arpruss/BLEBike/schematic.png

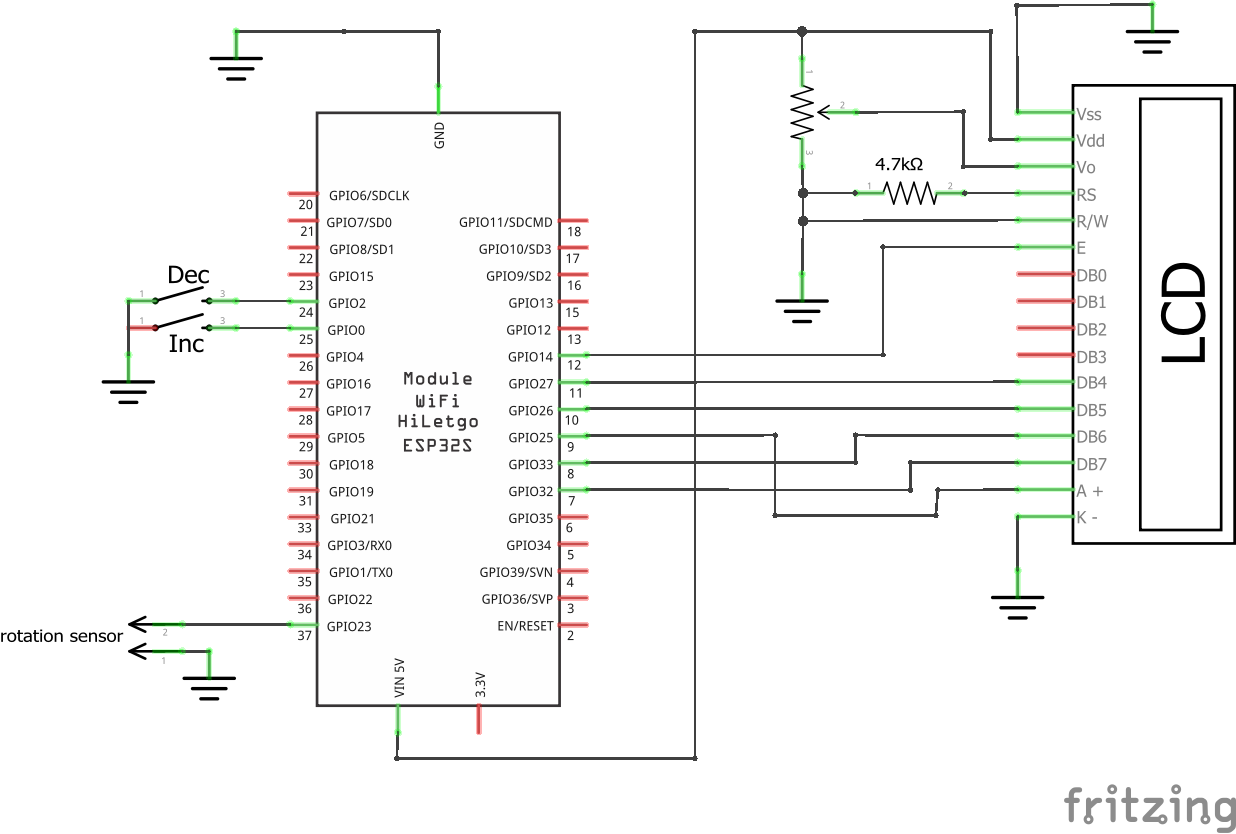
schematic.png
