arpruss/BLEBike/(threads)

Thread 1 (2023-03-22):

Cadence RPM seems to be half

MortenVinding, 2023-03-22:
Hi arpruss,

Your project is just what I need.

I have converted it to a platformio project in my fork here: https://github.com/MortenVinding/BLEBike.git
But it seems like the RPM counter is counting only half the revolutions.
Is this configurable on the display I haven't connected since I don't have a HD44780 display at hand?

/Morten

arpruss, 2023-03-23:
Do you know what the RPM sensor output is like on your bike? Is it normally high, with a low spike (how long?)? Or the other way around?

MortenVinding, 2023-03-23:
Also I only measured with a multimeter.
It’s normally high (4.29 volts if memory serves), and the low pulse seemed to be responsible long.

I will scoope that also later.
But it is precisely half of the build-in RPM display.
Changing the 60000 / in the code to 30000 / made it bang-on with the bikes computer.

arpruss, 2023-03-23:
Why don't you add a bit of code to the interrupt handler to toggle an LED reach time it detects a rotation, and then see what happens when you rotate the pedals slowly: do you miss every second one? You can also hook up a multimeter at the same time and make sure there was a signal that it missed.

It wouldn't surprise if there was some bug in my code. The ESP has trouble with triggering interrupts on a specific edge, and so I have to trigger on both edges and kludgily drop one.

Could be the same with the heart rate.

MortenVinding, 2023-03-23:
> Why don't you add a bit of code to the interrupt handler to toggle an LED each time it detects a rotation, and then see what happens when you rotate the pedals slowly: do you miss every second one? You can also hook up a multimeter at the same time and make sure there was a signal that it missed.

Great idea. I will do that. And also hook up my scope.

> It wouldn't surprise if there was some bug in my code. The ESP has trouble with triggering interrupts on a specific edge, and so I have to trigger on both edges and kludgily drop one.

Ahh that could also very well explain the half RPM number. So maybe for some weird reason, my ESP32 is only triggering on one of the edges.

> Could be the same with the heart rate.

Might yes. But there must also be something else going on, because it's much more off. Around 2-3 BPM when the bike registers around 70 BPM.

arpruss, 2023-03-24:
On my bike, there are two different heart lines. There are the lines to the sensors, and you are unlikely to be able to catch anything on them without some circuitry to amplify the faint signals, and there are digitally processed signals -- nice square waves -- that should be easier to work with. But I never actually tried that heart code, because I ended up getting a chest band, and so now I integrate that data over bluetooth.

MortenVinding, 2023-03-24:
Ohh and don't worry about the voltages, I forgot to zero out the DSO138 (yes it's a cheap scope 😆)
They do go 0-3.3 volt (rotation) and 0-4.2 volt (heart).

arpruss, 2023-03-24:
I wouldn't expect serial print to work inside an interrupt handler. Interrupt handlers need to move fast.

Did you configure the LED in your setup() (i.e., `pinMode(LED,OUTPUT)`)?  Then you need a bit of code like:
` static uint8_t ledState = 0; digitalWrite(LED, ledState); ledState = !ledState; `
in the ISR.

I suggest starting with putting that code right at the beginning of rotationISR();. You should only see a brief blink of the LED, because the width of the signal is narrow.

arpruss, 2023-03-24:
Try this. At the beginning of the ISR: digitalWrite(LED,digitalRead(rotationDetectPin)). This should exactly duplicate the rotation detect pin on the LED if both edges are being captured. If you can't tell from the LED what is going on, put the scope on the LED pin (or use a different output pin). Ideally you'd use a two-channel scope, one for the LED and the other for the rotation detect, and see if both channels are the same, but you can make-do with just one channel.

MortenVinding, 2023-03-24:
Thanks.

That seems to work reliably. The LED is on in a little more than 3/4 of the revolution and of in little less than 1/4.
So I guess it triggers the interrupt on both edges after all?

But if I change
`uint32_t rpm;
  uint32_t _power = _lastPower;
  if (!rev || _lastRotationDuration == 0)
    rpm = 0;
  else if (_lastRotationDuration < t - prevRotationMarker) {
    rpm = 60000 / (t - prevRotationMarker);
    _power = calculatePower(t - prevRotationMarker);
  }
  else
    rpm = 60000 / _lastRotationDuration;`

to 120000 instead of 60000, the RPM number is exactly the same as the bike computers.

arpruss, 2023-03-25:
I would rather figure out what is wrong than just change the timing to make it work, since even if that works for you, it won't work for others (e.g., it won't work for me).

I have two more test sfor you. Comment out these lines:
```
if (t < lastBounce + rotationMarkerDebounceTime) {
    lastBounce = t;
    return;
  }
```
And see if now the timing is right. If it is, then maybe play a bit with the rotationMarkerDebounceTime and making it smaller and see if that solves your problem.

If this doesn't solve the problem, then move the LED code to right before the `uint32_t t = millis();` line.

MortenVinding, 2023-03-25:
Absolutely agree.
It was only to explain that the RPM number is exactly half of the real.

I tried removing the `(t < lastBounce + rotationMarkerDebounceTime)` part but it did not change anything.
Haven't tried to put the LED code before `uint32_t t = millis();` but I did have it in the very top of the rotationISR part before.
Btw: I use the `ledPin` you have already configured in the code (that is GPIO 2 and the internal LED on my board).

I noticed that `lastBounce` is used both in `rotationISR` and `heartISR`, don't know if that's a problem.
I triede to rename it in the `rotationISR` handler, but that also didn't change anything.

Thank you so much for your help.

arpruss, 2023-03-25:
The use of the same bounce timer is definitely an issue I should look into.

arpruss, 2023-03-30:
lastBounce is static, so it's local to the two functions. No problem there.

Add an LED toggler at the end of rotationISR().
`static uint8_t ledState = 0; digitalWrite(LED, ledState); ledState = !ledState;`
Then you should have the LED toggling once per full rotation. Do you?

MortenVinding, 2023-03-31:
> Then you should have the LED toggling once per full rotation. Do you?

I already did that per your instructions before, but I tried to move it to the bottom of the rotationISR().
And yes it toggles once per revolution. Only once.

I think there is something strange going on with the ISR, because the heartbeat is way off, but if I swap the heart and rotation input, the rotation (now triggered by the heart sensor), is also exactly half of my heart rate (as displayed by the bike computer), and the heart rate (now triggerede by the rotation sensor) is showing the same strange behaviour as when the heart sensor was connected to it.

arpruss, 2023-03-31:
Toggling once per rotation is correct behavior. So the problem is somewhere else.

MortenVinding, 2023-03-31:
> Toggling once per rotation is correct behavior. So the problem is somewhere else.

but I thought there was a problem with the ESP32 interrupts triggering on both the rising and falling edge?

don’t you divide by 2 in the code? (I can’t figure it out. I’m terrible programmer 🙄)

arpruss, 2023-03-31:
Yes, the interrupt handler does trigger on rise and fall. But the following code makes sure that the fall is ignored:
```
if (cleanRotationMarkerState != defaultRotationMarkerValue)
    return;
  // trigger on end of marker
```
Try disabling the heart code completely (comment out `#define HEART_PIN`) and see if the rotation works better.

Another thing to try. After the `rpm = 60000 / _lastRotationDuration;` line, print to serial both the rpm and _lastRotationDuration. Then using a stopwatch, rotate the pedals slowly, so that a rotation takes about three seconds. Compare the three seconds the _lastRotationDuration (which is in milliseconds).

MortenVinding, 2023-04-01:
> Yes, the interrupt handler does trigger on rise and fall. But the following code makes sure that the fall is ignored:

Ahh of course!

> Try disabling the heart code completely (comment out `#define HEART_PIN`) and see if the rotation works better.

Tried. No change :(

> Another thing to try. After the `rpm = 60000 / _lastRotationDuration;` line, print to serial both the rpm and _lastRotationDuration. Then using a stopwatch, rotate the pedals slowly, so that a rotation takes about three seconds. Compare the three seconds the _lastRotationDuration (which is in milliseconds).

I added:
```
    Serial.print("RPM: ");
    Serial.println(rpm);
    Serial.print("_lastRotationDuration: ");
    Serial.println(_lastRotationDuration);
```
Pictures of output from it, from the bike computer and screenshot from Zwift.
Maybe I should try a different app?

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

arpruss, 2023-04-01:
So it looks like it IS correctly counting the rpm, but there is some problem in the transmission to Zwift.

The code sends data over multiple bluetooth services: cadence, power, heart and fitness. Based on your data, I think Zwift is picking up the fitness service data. Turn off the fitness service in the code (remove the FITNESS define at the top). See what happens.

MortenVinding, 2023-04-01:
> Turn off the fitness service in the code (remove the FITNESS define at the top). See what happens.

Wheee that was IT!!
Now the RPM is spot on!

That is so cool 💪

Unfortunately the heart rate is still too low. I will try the same with the serial debug messages on that now.

arpruss, 2023-04-02:
There is still a bug in the fitness service, or at least a compatibility problem with Zwift.

MortenVinding, 2023-04-02:
Ohh okay sorry…

arpruss, 2023-04-07:
I should have read the specs more carefully. Cadence in FTMS is measured in half-units. Your 120,000 fix was basically right. I corrected this, and also improved the rounding.

Closed 2023-04-07.

Thread 2 (2023-03-22):

Heart rate sensor is counting very low

MortenVinding, 2023-03-22:
I have build for heart sensor on pin 19.
It's connected to the existing heart sensor circuit in my exercise bike to pin 19, but it is counting very low. Not even 1/10 og the actual heart rate, maybe 1/80 - 1/100.
I can't really figure out the calculation, so hope you can help med figure out what is wrong.

/Morten

arpruss, 2023-03-23:
I haven't tested this functionality, so it wouldn't surprise me if there were a bug in it. How does your bike's sensor signal look? Is it a nice square wave?

MortenVinding, 2023-03-23:
Wow quick response 😊

That’s a very fair question.
The input is from a dedicated heart sensor circuit on the bike, but I have only measured it with a multimeter.
I have a simple DSO120 scope, I can hook up later today.

This is the heart circuit:
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

MortenVinding, 2023-04-01:
added:
```
    Serial.print("heartRate: ");
    Serial.println(heartRate);
    Serial.print("lastHeartRateTime: ");
    Serial.println(lastHeartRateTime);
```
right here:
```
#ifdef HEART_PIN
  static uint32_t lastHeartRateUpdate = 0;

  if (millis() >= lastHeartRateUpdate + 1000 && lastHeartBeatDuration > 0 && millis() <= prevHeartBeat + 4000) {
    uint16_t heartRate = (10000 + lastHeartBeatDuration/2) / lastHeartBeatDuration;
    lastHeartRate = heartRate;
    lastHeartRateTime = prevHeartBeat;
    Serial.print("heartRate: ");
    Serial.println(heartRate);
    Serial.print("lastHeartRateTime: ");
    Serial.println(lastHeartRateTime);
```

But the heartRate is exactly the same as reported in Zwift.

Do you have any suggestions to where I might add some more debug output?

arpruss, 2023-04-02:
Try changing the 10000 to 60000.

MortenVinding, 2023-04-02:
> Try changing the 10000 to 60000.

Guess you looked in my fork, because there I have already raised it from 1000 to 10000 😉
I now have tried to change it to 60000. I looks to be close, but now maybe a bit to high.
But the heart measurement seems to anyway be a bit unreliable, also for the build in computer. So maybe it's just that.

I would say it's good enough now.
Next step for me is implementing resistance control. That might be a bit more involved, but I hope I can steal some code from this: https://github.com/doudar/SmartSpin2k

All though my requirements are different, since my bike already have electrically controlled resistance using a small motor and a feedback potentiometer.

Once again, thank you so much for your help. Really appreciated.

In time I might make som pull requests, if you would like the OTA update feature etc.
