arpruss/BLEBike/schematic.pdf

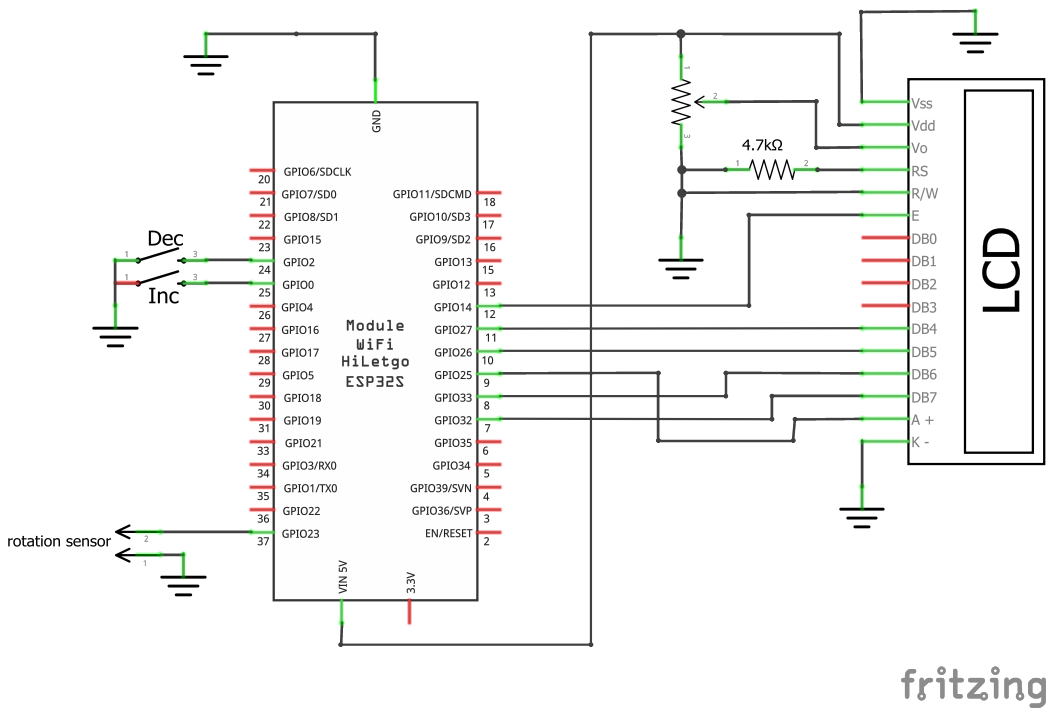
[picture p2: page 1]
