arpruss/BLEBike/BLEBike.ino

/*
 * MIT License
*/

#include <NimBLEDevice.h>
#include <NimBLEUtils.h>
#include <NimBLEServer.h>
#include <ArduinoNvs.h> // https://github.com/rpolitex/ArduinoNvs
#include "debounce.h"

#define SUPPORT_WIFI

#ifdef SUPPORT_WIFI
#include <WiFi.h>
#include "/Users/arpruss/Documents/Arduino/private.h"
IPAddress localIP(MY_IP);
IPAddress gateway(MY_GATEWAY);
IPAddress subnet(MY_SUBNET);
#define MY_PORT 8765
WiFiServer tcpServer(MY_PORT);
#endif

#define POWER
#define CADENCE
#define FITNESS
//#define HEART_BEACON 
//#define HEART_PIN 19 // untested
#define HEART_CLIENT

//#define WHEEL // Adds WHEEL to cadence; not supported in power as that would need a control point
#define LIBRARY_HD44780
#define PULLUP_ON_ROTATION_DETECT // handy for debugging

#if defined(HEART_BEACON) || defined(HEART_PIN) || defined(HEART_CLIENT)
# define HEART
#endif

#define HEART_MIBAND_UUID16 0xFEE0 

#define DEVICE_NAME "BLEBike"
const uint32_t rotationDetectPin = 23;

#ifdef LIBRARY_HD44780
# include <hd44780.h>
# include <hd44780ioClass/hd44780_pinIO.h> // Arduino pin i/o class header
#else
# include <LiquidCrystal.h>
#endif

#define COLS 20
#define ROWS 4

const int rs = 12, en = 14, d4 = 27, d5 = 26, d6 = 33, d7 = 32;
#define BACKLIGHT 25
// 1-16 on LCD board
// Left / Right on ESP32 with USB port at bottom
// Positions of pins may differ on your board.
// GND = Left from bottom 6, Right from top 7, Right from top 1
// 1 = GND -- Left from bottom 6
// 2 = VCC -- 5V = Left from bottom 1 (perhaps via diode?)
// 3 -- contrast pot wiper: right goes to +5V and left goes to GND
// 4 = RS -- GPIO12 = Left from bottom 7 -- 4.7k -- GND
// 5 = RW -- GND
// 6 = EN -- GPIO14 = Left from bottom 8
// 11 = D4 -- GPIO27 = Left from bottom 9
// 12 = D5 -- GPIO26 = Left from bottom 10
// 13 = D6 -- GPIO33 = Left from bottom 12
// 14 = D7 -- GPIO32 = Left from bottom 13
// 15 = GPIO25 -- Left from bottom 11
// 16 = GND
// Bike GND -- GND = Right from top 1
// Bike Detect -- GPIO23 = Right from top 2
// GND -- switch -- GPIO0 = Right from bottom 6
// GND -- switch -- GPIO4 = Right from bottom 7

#ifdef LIBRARY_HD44780
hd44780_pinIO
#else
LiquidCrystal 
#endif
lcd(rs, en, d4, d5, d6, d7);

byte bluetoothIcon[8] = {
  B00110, //..XX.
  B10101, //X.X.X
  B01110, //.XXX.
  B00100, //..X..
  B01110, //.XXX.
  B10101, //X.X.X
  B00110, //..XX.
  B00000, //.....
};

byte heartIcon[8] = {
   B00000,
   B01010,
   B10101,
   B10001,
   B10001,
   B01010,
   B00100,
   B00000
};
   

const uint32_t ledPin = 2;
const uint32_t incPin = 0;
const uint32_t decPin = 4; 
Debounce incButton(incPin, LOW);
Debounce decButton(decPin, LOW);
bool ignoreIncRelease = false;
bool ignoreDecRelease = false;
bool needToClear = true;
unsigned curX = 0;
unsigned curY = 0;
const uint8_t defaultRotationMarkerValue = 1; // this is what is there most of the time
uint8_t cleanRotationMarkerState = defaultRotationMarkerValue; // most likely
const uint8_t defaultHeartSensorValue = 1;
uint8_t cleanHeartSensorState = defaultHeartSensorValue;
const uint32_t rotationMarkerDebounceTime = 20;
const uint32_t heartSensorDebounceTime = 2;
const uint32_t minimumUpdateTime = 250;
const uint32_t idleTime = 4000; 
const uint32_t longPressTime = 2000;
bool cadenceServiceEnabled = true;
bool powerServiceEnabled = true;
bool heartServiceEnabled = true;
bool fitnessServiceEnabled = true;
bool heartReadEnabled = true;
bool showPeleton = true;
bool updateBluetooth = false;
bool wiFiMode = false;

uint32_t prevRotationMarker = 0;
uint32_t rotationMarkers = 0;
uint32_t lastRotationDuration = 0;
uint32_t lastPower = 0;
uint32_t pedalStartTime = 0;
uint64_t millijoules = 0;
uint32_t pedalledTime = 0;
#ifdef HEART_PIN
uint32_t heartBeats = 0;
uint32_t lastHeartBeatDuration = 0;
uint32_t prevHeartBeat = 0;
#endif
#ifdef HEART_BEACON
bool needToReportHeartRate = false;
uint64_t heartAddress=0;
uint8_t heartAddressType=1;
int bestHeartRSSI=-1000000;
uint64_t bestHeartAddress=0;
NimBLEScan* heartScan;
#define HEART_SENSOR_ON_WRIST
#endif
#ifdef HEART_CLIENT
bool needToReportHeartRate = false;
uint64_t heartAddress=0;
uint8_t heartAddressType=1;
int bestHeartRSSI=-1000000;
uint64_t bestHeartAddress=0;
NimBLEScan* heartScan;
NimBLEClient* heartClient = NULL;
NimBLEAdvertisedDevice* heartDevice;
bool needToConnectHeart = false;
uint32_t heartConnectAttemptTime;
unsigned heartConnectRetry=0;
const unsigned heartConnectRetries=5;
const uint32_t heartConnectRetryTime = 10000;
#endif

#ifdef HEART
uint32_t lastHeartRate = 0;
uint32_t lastHeartRateTime = 0;
#endif
bool detectedRotation = false;

uint32_t lastUpdateTime = 0;

#ifdef WHEEL
const uint32_t gearRatio1 = 1; // gearRatio1:gearRatio2 = wheel rotations:crank rotations
const uint32_t gearRatio2 = 2; 
#endif

#define GROSS_EFFICIENCYx1000 195 // 195 recumbent, 206 upright, at max power output: https://doi.org/10.3389/fspor.2021.667564
#define MJ_TO_KCALx1000 239
#define NUM_RESISTANCES 8
#define RADIUSX1000 149 // radius of crank in meters * 1000 (= radius of crank in mm)

#define FV(x) (uint32_t)(2 * PI * RADIUSX1000 * (x) + 0.5)

// compile-time calculations are down with floating point, but run-time calculation are all integer
//#define MECHANICAL_FRICTION_BIKE
#ifdef MECHANICAL_FRICTION_BIKE
// resistance model: force = - mechanicalFriction
const uint32_t mechanicalPartsX1000[NUM_RESISTANCES] = 
   { FV(7.5),FV(15.5),FV(20.5),FV(35.5),FV(50.5),FV(70.4),FV(70.9),FV(90.3) };
   // replace the numbers by your mechanical friction values in Newtons
#define WATTS(rpm,i) ( mechanicalPartsX1000[(i)] / 1000. * (rpm)/60. )
#else
// resistance model: force = - resistanceCoeffRots * rotationsPerTime - mechanicalFriction
// The following are the k values from https://www.instructables.com/Measure-Exercise-Bike-Powercalorie-Usage/
// multiplied by a factor of 10.
const uint32_t resistanceCoeffRotsX10[NUM_RESISTANCES] = {285,544,802,1052,1393,1671,1873,1969}; 
const uint32_t _2_pi_r_100000 = (uint32_t) (2 * PI * RADIUSX1000 * 100 + 0.5);
const uint32_t mechanicalPartX1000 = FV( 7.84 );   // mechanical friction measured at 7.84 Newtons
#define WATTS(rpm,i) ( (2 * PI * (RADIUSX1000/1000.) * (rpm)/60. * ( resistanceCoeffRotsX10[(i)]/10.*(rpm)/60.)) + mechanicalPartX1000/1000. * (rpm)/60.)
#endif
#define PEQ(i) (uint32_t)( ( (86.6+WATTS(60,(i)))/3.98 + (183.1+WATTS(80,(i)))/7.78 + (279.1+WATTS(100,(i)))/11.73) / 3 + 0.5 )
const uint32_t peletonResistances[NUM_RESISTANCES] = {PEQ(0),PEQ(1),PEQ(2),PEQ(3),PEQ(4),PEQ(5),PEQ(6),PEQ(7)};

byte resistanceValue = 0;
byte savedResistanceValue = 0;
const byte defaultBrightnessValue = 205;
byte brightnessValue;
byte savedBrightnessValue;

// references: https://github.com/sputnikdev/bluetooth-gatt-parser/blob/master/src/main/resources/gatt/characteristic/
// https://github.com/oesmith/gatt-xml/
// https://www.bluetooth.com/specifications/specs/fitness-machine-service-1-0/

#define ID(x) (NimBLEUUID((uint16_t)(x)))

struct CSCMeasurement_t {
  uint8_t flags; // bit 0: wheel data present; bit 1: crank data present
#ifdef WHEEL  
  uint32_t wheelRevolutions;
  uint16_t lastWheelEvent;
#endif  
  uint16_t crankRevolutions;
  uint16_t lastCrankEvent;
} __packed;

CSCMeasurement_t cscMeasurement = { .flags = (1<<1) // crank data
#ifdef WHEEL
  |(1<<0)
#endif
};

struct PowerMeasurement_t {
  uint16_t flags; // bit 4: wheel data present; bit 5: crank data present
  int16_t instantaneousPower;
// WHEEL would require the unsupported control point  
//#ifdef WHEEL  
//  uint32_t wheelRevolutions;
//  uint16_t lastWheelEvent;
//#endif  
  uint16_t crankRevolutions;
  uint16_t lastCrankEvent;
} __packed;

PowerMeasurement_t powerMeasurement = { .flags = 
  (1<<5) // crank data
//#ifdef WHEEL
//  |(1<<4) // wheel data
//#endif  
}; 
byte cscFeature = 2 // crank revolution
#ifdef WHEEL
 |1
#endif
; 
uint32_t powerFeature = 8 // crank revolution
//#ifdef WHEEL
// |4
//#endif
;
byte powerlocation = 6; // right crank

struct HeartMeasurement8_t {
  uint8_t flags;
  uint8_t heartRate;
} __packed;

HeartMeasurement8_t heartMeasurement8 = { .flags = 0 };
#ifdef HEART_SENSOR_ON_WRIST
byte heartLocation = 2;
#endif

struct HeartMeasurement16_t {
  uint8_t flags;
  uint16_t heartRate;
} __packed;

HeartMeasurement8_t heartMeasurement16 = { .flags = 1 };

#ifdef FITNESS
struct FitnessFeature_t {
  uint32_t machineFeatures;
  uint32_t targetSettingFeatures;
} __packed;

#define FITNESS_FEATURE_CADENCE (1<<1)
#define FITNESS_FEATURE_RESISTANCE (1<<7)
#define FITNESS_FEATURE_HEART (1<<10)
#define FITNESS_FEATURE_POWER (1<<14)
#define FITNESS_UUID16 0x1826
#define FITNESS_UUID ID(FITNESS_UUID16)

FitnessFeature_t fitnessFeature = { 
  .machineFeatures = FITNESS_FEATURE_CADENCE|FITNESS_FEATURE_RESISTANCE|FITNESS_FEATURE_POWER
};

struct FitnessServiceData_t {
  uint8_t flags;
  uint16_t machineType;
} __packed;

const FitnessServiceData_t fitnessServiceData {
  .flags = 1,
  .machineType = (1<<5) // indoor bike
};

struct BikeData_t {
  uint16_t flags;
  uint16_t cadence_x2;
  uint16_t resistance;
  uint16_t power;
  uint8_t heart;
} __packed;

#define BIKE_DATA_FLAG_HEART (1<<9)

// https://github.com/oesmith/gatt-xml/blob/master/org.bluetooth.characteristic.indoor_bike_data.xml seems to have some errors!
BikeData_t bikeData = {
  .flags = (1)|(1<<2)|(1<<5)|(1<<6) // more data,cadence,resistance,power
};

#endif

bool bleConnected = false;

#ifdef CADENCE
#define CADENCE_UUID ID(0x1816)
NimBLECharacteristic cscMeasurementCharacteristics(ID(0x2A5B), NIMBLE_PROPERTY::NOTIFY);
NimBLECharacteristic cscFeatureCharacteristics(ID(0x2A5C), NIMBLE_PROPERTY::READ);
#endif

#ifdef POWER
#define POWER_UUID ID(0x1818)
NimBLECharacteristic powerMeasurementCharacteristics(ID(0x2A63), NIMBLE_PROPERTY::NOTIFY);
NimBLECharacteristic powerFeatureCharacteristics(ID(0x2A65), NIMBLE_PROPERTY::READ);
NimBLECharacteristic powerSensorLocationCharacteristics(ID(0x2A5D), NIMBLE_PROPERTY::READ);
#endif

#ifdef HEART
#define HEART_UUID ID(0x180D)
NimBLECharacteristic heartMeasurementCharacteristics(ID(0x2A37), NIMBLE_PROPERTY::NOTIFY);
#ifdef HEART_SENSOR_ON_WRIST
NimBLECharacteristic heartSensorLocationCharacteristics(ID(0x2A38), NIMBLE_PROPERTY::READ);
#endif
#ifdef HEART_MIBAND_UUID16
NimBLEUUID MIBAND_ADV_UUID((uint16_t)HEART_MIBAND_UUID16);
#endif
#endif

#ifdef FITNESS
NimBLECharacteristic bikeDataCharacteristics(ID(0x2AD2), NIMBLE_PROPERTY::NOTIFY);
NimBLECharacteristic fitnessFeatureCharacteristics(ID(0x2ACC), NIMBLE_PROPERTY::READ);
#endif

#define MAX_SUBOPTIONS 2

typedef struct {
  unsigned key;
  const char* heading;
  const char* subOptions[MAX_SUBOPTIONS+1];
} MenuEntry_t;

enum {
  SHOW_PELETON,
  SEND_CADENCE,
  SEND_POWER,
  SEND_FITNESS,
  SEND_HEART,
  CLEAR,
  RESUME,
  RECONNECT_HEART,
  RESCAN_HEART
};

MenuEntry_t menuData[] = {
  { SHOW_PELETON, "Show Pel equiv", {"No", "Yes"} },
#ifdef POWER  
  { SEND_POWER, "Send power", {"No", "Yes" } },
#endif
#ifdef CADENCE  
  { SEND_CADENCE, "Send cadence", { "No", "Yes" } },
#endif
#ifdef FITNESS
  { SEND_FITNESS, "Send fitness", { "No", "Yes" } },
#endif  
#ifdef HEART
  { SEND_HEART, "Send heart", { "No", "Yes" } },
#endif  
  { RESUME, "Resume", {NULL} },
  { CLEAR, "Clear and reboot", {NULL} },
#if defined( HEART_CLIENT )
  { RECONNECT_HEART, "Reconnect HRM", {NULL} },
#endif  
#if defined( HEART_BEACON ) || defined( HEART_CLIENT )
  { RESCAN_HEART, "Rescan for HRM", {NULL} },
#endif  
};

#define NUM_OPTIONS (sizeof menuData / sizeof *menuData)

class MyServerCallbacks:public NimBLEServerCallbacks
{
  void onConnect(NimBLEServer* pServer)
  {
    Serial.println("connected");
    bleConnected = true;
    if (pServer->getConnectedCount() < CONFIG_BT_NIMBLE_MAX_CONNECTIONS
#if defined( HEART_BEACON ) || defined( HEART_CLIENT )
    -1
#endif    
    ) {
      /*
      NimBLEAdvertisementData data;
      data.setManufacturerData("\xE5\x02Omega Centauri"); // use Espressif's manufacturer code
      data.setName(DEVICE_NAME);
      const std::vector< NimBLEUUID > services { HEART_UUID }; // , CADENCE_UUID, POWER_UUID };
      
      data.setCompleteServices16(services);
      NimBLEDevice::getAdvertising()->setAdvertisementData(data); */
      
      BLEDevice::startAdvertising();
    } else {
      BLEDevice::stopAdvertising();
    }
  };

  void onDisconnect(NimBLEServer* pServer)
  {
    Serial.println("disconnected");
    NimBLEDevice::startAdvertising();
    bleConnected = false;
  }
};

MyServerCallbacks serverCallbacks;

#if defined( HEART_CLIENT ) || defined( HEART_BEACON )


void heartRate(unsigned rate) {
   lastHeartRate = rate;
   needToReportHeartRate = true;
   lastHeartRateTime = millis();
}
#endif

#ifdef HEART_CLIENT
void heartDataCallback( NimBLERemoteCharacteristic* chr, uint8_t* data, size_t length, bool isNotify) {
  if (length < 1)
    return;
  if (data[0] & 1) {
    if (length < 3)
      return;
    heartRate( data[1] + 256 * data[2] );
  }
  else {
    if (length < 2)
      return;
    heartRate( data[1] );
  }
}



class HeartCallbacks: public NimBLEClientCallbacks {
  virtual void onDisconnect(NimBLEClient* client) {
    Serial.println("heart device disconnected event");
    heartRate(0);
    needToConnectHeart = true;
    heartConnectAttemptTime = millis() + 1000 - heartConnectRetryTime;
    heartConnectRetry = 0;
  }
  virtual void onConnect(NimBLEClient* client) {
    Serial.println("heart device connected event");
  }
};

HeartCallbacks heartCallbacks;


class MyAdvertisedDeviceCallbacks: public NimBLEAdvertisedDeviceCallbacks {
    void onResult(NimBLEAdvertisedDevice* advertisedDevice) {
      if (advertisedDevice->getAddress().getType() != heartAddressType) 
        return;
      uint64_t address = (uint64_t)(advertisedDevice->getAddress());
      if (heartAddress != 0) {
        if (address != heartAddress) {
          return;
        }
      }
      else {
        if (! advertisedDevice->haveRSSI())
          return;
        int rssi = advertisedDevice->getRSSI();
        if (address != bestHeartAddress && rssi < bestHeartRSSI)
          return;
        if (!advertisedDevice->isAdvertisingService( HEART_UUID)) 
          return;
        if (rssi > bestHeartRSSI) {
          bestHeartRSSI = rssi;
          bestHeartAddress = address;
          heartDevice = advertisedDevice;
          Serial.printf("Best found: %llx (RSSI %d)\n", address, rssi);
        }
      }
    }
};

bool doHeartConnect() {  
  heartClient->setClientCallbacks(&heartCallbacks, false);
  heartClient->setConnectionParams(12, 12, 0, 100);
  heartClient->setConnectTimeout(5);
  heartClient->disconnect();
  
  if ( ! heartClient->connect(NimBLEAddress(heartAddress, 1)) ) {
    return false;
  } 
  else {
    Serial.println("heart connect success");
    NimBLERemoteService* service = heartClient->getService(HEART_UUID);
    if (service == NULL) {
      heartClient->disconnect();
      return false;
    }
    else {      
      Serial.println("success getting service");
      NimBLERemoteCharacteristic *chr = service->getCharacteristic(ID(0x2A37));
      if (chr == NULL) {
        Serial.println("fail in getting characteristic");
        heartClient->disconnect();
        return false;
      }
      Serial.println("got characteristic");
      // TODO: check ret value
      chr->subscribe(true, heartDataCallback, false);
      Serial.println("subscribed");
      return true;
    }
  }
}

void heartConnectTask(void* args) {
  Serial.println("attempting to connect heart");
  needToConnectHeart = false;
  if (!doHeartConnect()) {
    Serial.println("connection failed");
    heartConnectRetry++;
    if (heartConnectRetry > heartConnectRetries) {
      Serial.println("too many retries");
      needToConnectHeart = false;
    }
    else {
      Serial.println("will retry");
      needToConnectHeart = true;
      heartConnectAttemptTime = millis();
    }
  }
}

void heartConnect(void) {
//  xTaskCreate(heartConnectTask, "heart connect", 10000, NULL, 1, NULL);
  heartConnectTask(NULL);
}

void heartScanDone(NimBLEScanResults res) {
  if (bestHeartAddress != 0) {
    heartAddress = bestHeartAddress;
    NVS.setInt("heartAddress", heartAddress);
    Serial.printf("Saving address: %llx (RSSI %d)\n", heartAddress, bestHeartRSSI);
    heartConnectRetry = 0;
    heartConnect();
  }
  else {
    Serial.println("reset scan");
    startHeartScan();
  }
}

void startHeartScan() {
    needToConnectHeart = false;
    bestHeartAddress = 0;
    bestHeartRSSI = -1000000;
    Serial.println("disconnecting");
    heartClient->disconnect();
    Serial.println("scanning");
    heartScan->start(30, heartScanDone, false);  
}
#endif


#ifdef HEART_BEACON

uint8_t* getPayloadItem(uint8_t* p, unsigned l, uint8_t type) {
  if (l<2)
    return NULL;
  while (true) {
    unsigned itemLength = 1 + (unsigned)p[0];
    if (p[1] == type && itemLength <= l) {
      return p;
    }
    if (itemLength >= l)
      return NULL;
    p += itemLength;
    l -= itemLength;
  }
}

class MyAdvertisedDeviceCallbacks: public NimBLEAdvertisedDeviceCallbacks {
    void onResult(NimBLEAdvertisedDevice* advertisedDevice) {
      if (advertisedDevice->getAddress().getType() != heartAddressType) 
        return;
      uint64_t address = (uint64_t)(advertisedDevice->getAddress());
      int rssi = advertisedDevice->getRSSI();
      if (heartAddress != 0) {
        if (address != heartAddress) {
          return;
        }
      }
      else {
        if (! advertisedDevice->haveRSSI())
          return;
        if (address != bestHeartAddress && rssi < bestHeartRSSI)
          return;
        Serial.printf("Examining: %llx (RSSI %d)\n", address, rssi);
      }      
      bool isGood = false;
      // check if it's a miband watch broadcasting heart rate
      std::string serviceData = advertisedDevice->getServiceData(MIBAND_ADV_UUID);
      unsigned l = serviceData.length();
      if (l == 5) {
        unsigned char* p = (unsigned char*)(serviceData.data());
        heartRate(p[4]);
        isGood = true;
      }
      // check if it's a cheap heart strap broadcasting rate
      if (!isGood && (heartAddress != 0 || advertisedDevice->isAdvertisingService(HEART_UUID))) {
        // look for 0xFF section in advertising
        uint8_t* payload = advertisedDevice->getPayload();
        unsigned l = advertisedDevice->getPayloadLength();
        uint8_t* item = getPayloadItem(payload, l, 0xFF);
        if (item != NULL) {
          unsigned itemLength = item[0];
          if (itemLength == 7) {
            heartRate(item[7]);
            isGood = true;
          }
        }        
      }
      
      if (heartAddress == 0 && rssi > bestHeartRSSI && isGood) {
        bestHeartRSSI = rssi;
        bestHeartAddress = address;
        Serial.printf("Best beacon found: %llx (RSSI %d)\n", address, rssi);
      }
    }
};

void startHeartScan();

void heartScanDone(NimBLEScanResults res) {
  Serial.println("reset scan");
  if (heartAddress == 0 && bestHeartAddress != 0) {
    heartAddress = bestHeartAddress;
    NVS.setInt("heartAddress", heartAddress);
    Serial.printf("Saving address: %llx (RSSI %d)\n", heartAddress, bestHeartRSSI);
  }
  startHeartScan();
}

void startHeartScan() {
    if (heartAddress != 0) {
      size_t count = NimBLEDevice::getWhiteListCount();
      if (count == 0 || (uint64_t)NimBLEDevice::getWhiteListAddress(0) != heartAddress) {
        Serial.println("resetting whitelist");
        for (int i = count - 1 ; i >= 0 ; i--)
          NimBLEDevice::whiteListRemove(NimBLEDevice::getWhiteListAddress(i));
        BLEAddress toAdd(heartAddress,heartAddressType);
        NimBLEDevice::whiteListAdd(toAdd);
      }
      heartScan->setFilterPolicy(BLE_HCI_SCAN_FILT_USE_WL);
    }
    else {
      bestHeartAddress = 0;
      bestHeartRSSI = -1000000;
      heartScan->setFilterPolicy(BLE_HCI_SCAN_FILT_NO_WL);
    }
    heartScan->start(30, heartScanDone, false);  
}
#endif

#ifdef HEART_CLIENT
void heartConnect();
#endif

void InitNimBLE()
{
  if (!powerServiceEnabled && !cadenceServiceEnabled && !heartReadEnabled && !fitnessServiceEnabled)
    return;
  
  NimBLEDevice::init(DEVICE_NAME);
  NimBLEServer *pServer = wiFiMode ? NULL : NimBLEDevice::createServer();

// TODO: if all outgoing services are disabled, but this is enabled, we should do this without a server
#ifdef HEART_CLIENT
  if (heartReadEnabled) {
    heartClient = NimBLEDevice::createClient();
    heartScan = NimBLEDevice::getScan();
    heartScan->setAdvertisedDeviceCallbacks(new MyAdvertisedDeviceCallbacks(),true);
    heartScan->setActiveScan(true);
    heartScan->setMaxResults(0);
    heartAddress = NVS.getInt("heartAddress", 0);
    Serial.printf("Heart address: %llx\n", heartAddress);
    if (heartAddress != 0) {
      Serial.println("will need to connect");
      needToConnectHeart = true;
      heartConnectRetry = 0;
    }
    else {
      needToConnectHeart = false;
      //startHeartScan();
    }
  }
#endif

  NimBLEAdvertising *pAdvertising;

  if (pServer == NULL)
    goto SKIP_BLE_SERVER;
    
  pServer->setCallbacks(&serverCallbacks);
  pAdvertising = NimBLEDevice::getAdvertising();

#ifdef CADENCE
  if (cadenceServiceEnabled) {
    Serial.println("cadence data");
    NimBLEService *pCadence = pServer->createService(CADENCE_UUID);
  
    pCadence->addCharacteristic(&cscMeasurementCharacteristics);
  
    pCadence->addCharacteristic(&cscFeatureCharacteristics);
    cscFeatureCharacteristics.setValue(&cscFeature, 1);
  
    pAdvertising->addServiceUUID(CADENCE_UUID);
  
    pCadence->start();
  }
#endif

#ifdef POWER
  if (powerServiceEnabled) {
    Serial.println("power data");
    NimBLEService *pPower = pServer->createService(POWER_UUID);
  
    pPower->addCharacteristic(&powerMeasurementCharacteristics);
    
    pPower->addCharacteristic(&powerFeatureCharacteristics);
    powerFeatureCharacteristics.setValue((uint8_t*)&powerFeature, sizeof(powerFeature));
    
    pPower->addCharacteristic(&powerSensorLocationCharacteristics);
    powerSensorLocationCharacteristics.setValue(&powerlocation, 1);  
  
    pAdvertising->addServiceUUID(POWER_UUID);
  
    pPower->start();
  }
#endif

#ifdef HEART
  if (heartServiceEnabled) {
    Serial.println("heart data");
    NimBLEService *pHeart = pServer->createService(HEART_UUID);
  
    pHeart->addCharacteristic(&heartMeasurementCharacteristics);

#ifdef HEART_SENSOR_ON_WRIST    
    pHeart->addCharacteristic(&heartSensorLocationCharacteristics);
    heartSensorLocationCharacteristics.setValue(&heartLocation, 1);  
#endif    
  
    pAdvertising->addServiceUUID(HEART_UUID);
  
    pHeart->start();
  }
#endif

#ifdef FITNESS
  if (fitnessServiceEnabled) {
    Serial.println("fitness data");
    NimBLEService *pFitness = pServer->createService(FITNESS_UUID);
  
    pFitness->addCharacteristic(&bikeDataCharacteristics);
    pFitness->addCharacteristic(&fitnessFeatureCharacteristics);
#ifdef HEART   
    if (heartServiceEnabled) {
      fitnessFeature.machineFeatures |= FITNESS_FEATURE_HEART;      
    }
#endif
    fitnessFeatureCharacteristics.setValue((uint8_t*)&fitnessFeature, sizeof(fitnessFeature));

    pAdvertising->addServiceUUID(FITNESS_UUID);
  
    pFitness->start();
    NimBLEAdvertisementData data;
    std::string sd( (char*)&fitnessServiceData, sizeof(fitnessServiceData));
    data.setServiceData(FITNESS_UUID, sd);
    pAdvertising->setScanResponseData(data); 
    pAdvertising->setScanResponse(true);
  }
  else {
    pAdvertising->setScanResponse(false);
  }
#else
  pAdvertising->setScanResponse(false);
#endif  
  pAdvertising->setMinPreferred(0x06);  // functions that allegedly help with iPhone connections issue
  pAdvertising->setMaxPreferred(0x12);

  pAdvertising->setMaxInterval(250);
  pAdvertising->setMinInterval(160);

  pServer->advertiseOnDisconnect(true);

  Serial.println("advertising");
  NimBLEDevice::startAdvertising();

SKIP_BLE_SERVER:

// TODO: if all outgoing services are disabled, but this is enabled, we should do this without a server
#ifdef HEART_BEACON
  if (heartReadEnabled) {
    heartAddress = NVS.getInt("heartAddress", 0);
    Serial.printf("Band address: %llx\n", heartAddress);
    heartScan = NimBLEDevice::getScan();
    heartScan->setAdvertisedDeviceCallbacks(new MyAdvertisedDeviceCallbacks(),true);
    heartScan->setActiveScan(true);
    heartScan->setMaxResults(0);
    startHeartScan();
  }
#endif  

  Serial.println("NimBLE initialized");
  
#ifdef HEART_CLIENT 
  Serial.println("heart client?"); 
  if (needToConnectHeart) {
    heartConnect();
  }
#endif  
}

void setResistance(uint32_t value) {  
    resistanceValue = value;
}

void setBrightness(uint8_t value) {
    brightnessValue = value;
    dacWrite(BACKLIGHT, brightnessValue);
}

uint32_t calculatePower(uint32_t revTimeMillis) {
  if (revTimeMillis == 0)
    return 0;
    // https://www.instructables.com/Measure-Exercise-Bike-Powercalorie-Usage/
#ifdef MECHANICAL_RESISTANCE_BIKE
  return (mechanicalPartsX1000[resistanceValue] + revTimeMillis/2) / revTimeMillis;
#else    
  return (_2_pi_r_100000 * resistanceCoeffRotsX10[resistanceValue] / revTimeMillis + mechanicalPartX1000 + revTimeMillis/2) / revTimeMillis;
#endif  
}

inline uint16_t getTime1024ths(uint32_t ms) 
{
  // TODO: there will be a glitch every 4.66 hours
  ms &= 0x00FFFFFFul;
  return ms * 128/125;
}

void IRAM_ATTR rotationISR() {
  static uint32_t lastBounce = 0;

  if (digitalRead(rotationDetectPin) == cleanRotationMarkerState)
    return;

  uint32_t t = millis();

  if (t < lastBounce + rotationMarkerDebounceTime) {
    lastBounce = t;
    return;
  }

  lastBounce = t;

  cleanRotationMarkerState = ! cleanRotationMarkerState;

  if (cleanRotationMarkerState != defaultRotationMarkerValue)
    return; 
  // trigger on end of marker
  // TODO: figure out if the debounce algorithm is solid
      
  if (rotationMarkers > 0) {
    lastRotationDuration = t - prevRotationMarker;
    lastPower = calculatePower(lastRotationDuration);
    millijoules += lastPower * lastRotationDuration;
  }
  else {
    pedalStartTime = t;
  }
  rotationMarkers++;
  prevRotationMarker = t;
  detectedRotation = true;
}

#ifdef HEART_PIN
void IRAM_ATTR heartISR() {
  static uint32_t lastBounce = 0;

  if (digitalRead(heartSensorPin) == cleanHeartSensorState)
    return;

  uint32_t t = millis();

  if (t < lastBounce + heartSensorDebounceTime) {
    lastBounce = t;
    return;
  }

  lastBounce = t;

  cleanHeartSensorState = ! cleanHeartSensorState;

  if (cleanHeartSensorState != defaultHeartSensorValue)
    return; 
  // trigger on end of sensor value
  // TODO: figure out if the debounce algorithm is solid
      
  if (heartBeats > 0) {
    lastHeartBeatDuration = t - prevHeartBeat;
  }
  heartBeats++;
  prevHeartBeat = t;
}
#endif

void print(const char* text) 
{
  while (*text && curX < COLS) {
    lcd.write(*text++);
    curX++;
  }
}

void clearToEOL() 
{
  while(curX < COLS) {
    lcd.write(' ');
    curX++;
  }
}

void setCursor(unsigned x, unsigned y) 
{
  lcd.setCursor(x,y);
  curX = x;
  curY = y;
}

void clear()
{
  lcd.clear();
  needToClear = false;
  setCursor(0,0);
}

#ifdef SUPPORT_WIFI
void InitWiFi() {
  WiFi.config(localIP, gateway, subnet);
  //WiFi.mode(WIFI_STA);
  WiFi.begin(MY_SSID, MY_PASSWORD);
  while (WiFi.status() != WL_CONNECTED)
    delay(500);
  tcpServer.begin();
}
#endif

void setup()
{
//esp_base_mac_addr_set(new_mac);

  
  pinMode(BACKLIGHT, OUTPUT);
  dacWrite(BACKLIGHT,brightnessValue);
  lcd.begin(COLS,ROWS);
  lcd.createChar(1, bluetoothIcon);
  lcd.createChar(2, heartIcon);
  clear();
  print("BLEBike");
  setCursor(0,1);
  print("Omega Centauri Soft");
  delay(1000);
  pinMode(incPin, INPUT_PULLUP);
  pinMode(decPin, INPUT_PULLUP);
#ifdef SUPPORT_WIFI  
  while (digitalRead(decPin) == 0)
    wiFiMode = true;
#endif    
  setCursor(0,2);
  print(wiFiMode ? "WiFi mode" : "BLE mode");
  Serial.begin(115200);
  Serial.println("BLEBike start");
  Serial.println(wiFiMode ? "WiFi mode" : "BLE mode");
#ifdef PULLUP_ON_ROTATION_DETECT  
  pinMode(rotationDetectPin, INPUT_PULLUP); 
#else
  pinMode(rotationDetectPin, INPUT); 
#endif  
#ifdef HEART_PIN
  pinMode(HEART_PIN, INPUT);
  attachInterrupt(HEART_PIN, heartISR, CHANGE);
#endif
  // it would be better to trigger on FALLING or on RISING, but the debounce would be tricky,
  // and neither FALLING or RISING trigger seems reliable: https://github.com/espressif/arduino-esp32/issues/1111
  attachInterrupt(rotationDetectPin, rotationISR, CHANGE);
  pinMode(ledPin, OUTPUT);
  digitalWrite(ledPin, 0);
  cleanRotationMarkerState = digitalRead(rotationDetectPin);

  NVS.begin();
  setResistance(NVS.getInt("res", 0));
  savedResistanceValue = resistanceValue;
  setBrightness(NVS.getInt("bright", defaultBrightnessValue));
  savedBrightnessValue = brightnessValue;
#ifdef POWER  
  powerServiceEnabled = (bool)NVS.getInt("power", true);
#else
  powerServiceEnabled = false;
#endif
#ifdef CADENCE
  cadenceServiceEnabled = (bool)NVS.getInt("cadence", true);
#else
  cadenceServiceEnabled = false;
#endif
#ifdef FITNESS
  fitnessServiceEnabled = (bool)NVS.getInt("fitness", true);
#else
  fitnessServiceEnabled = false;
#endif
#ifdef HEART
  heartServiceEnabled = (bool)NVS.getInt("heart", true);
  heartReadEnabled = heartServiceEnabled || fitnessServiceEnabled;
#else
  heartServiceEnabled = false;
  heartReadEnabled = false;
#endif  
  showPeleton = (bool)NVS.getInt("peleton", false);
  needToClear = true;

#ifdef SUPPORT_WIFI
  if (wiFiMode)
    InitWiFi();
#endif  
  InitNimBLE();
}

void printdigits(unsigned n, unsigned x, bool leftAlign=false) {
  const unsigned maxDigits = 10;
  char buffer[maxDigits+1];
  if (n>maxDigits)
    n=maxDigits;
  if (n==0)
    return;
  char*p = buffer+maxDigits;
  *p = 0;
  do {
    *--p = '0' + (x % 10);
    x /= 10;
    n--;
  } while(n>0 && x);
  if (x) {
    char *q = p;
    while(*q) {
      *q++ = '#';
    }
  }
  if (leftAlign) {
    print(p);
    while(n--)
      print(" ");
    return;
  }
  while(n>0) {
    *--p = ' ';
    n--;
  }
  print(p);
}

unsigned getSuboption(unsigned option) {
  switch(menuData[option].key) {
    case SEND_CADENCE:
      return cadenceServiceEnabled ? 1 : 0;
    case SEND_FITNESS:
      return fitnessServiceEnabled ? 1 : 0;
    case SEND_POWER:
      return powerServiceEnabled ? 1 : 0;
    case SEND_HEART:
      return heartServiceEnabled ? 1 : 0;
    case SHOW_PELETON:
      return showPeleton ? 1 : 0;
    //case CLEAR:
    default:
      return 0;
  }
}

void setSuboption(unsigned option, unsigned subOption) {
  switch(menuData[option].key) {
    case SEND_CADENCE:
      if ( cadenceServiceEnabled != ( subOption != 0 ) ) {
        cadenceServiceEnabled = (subOption != 0);
        NVS.setInt("cadence", (int)cadenceServiceEnabled);
        updateBluetooth = true;
      }
      break;
    case SEND_POWER:
      if ( powerServiceEnabled != ( subOption != 0 ) ) {
        powerServiceEnabled = (subOption != 0);
        NVS.setInt("power", (int)powerServiceEnabled);
        updateBluetooth = true;
      }
      break;
    case SEND_FITNESS:
      if ( fitnessServiceEnabled != ( subOption != 0 ) ) {
        fitnessServiceEnabled = (subOption != 0);
        NVS.setInt("fitness", (int)fitnessServiceEnabled);
        updateBluetooth = true;
      }
      break;
    case SEND_HEART:
      if ( heartServiceEnabled != ( subOption != 0 ) ) {
        heartServiceEnabled = (subOption != 0);
        NVS.setInt("heart", (int)heartServiceEnabled);
        updateBluetooth = true;
      }
      break;
    case SHOW_PELETON:
      if ( showPeleton != ( subOption != 0 ) ) {
        showPeleton = (subOption != 0);
        NVS.setInt("peleton", (int)showPeleton);
      }
      break;
    case CLEAR:
      ESP.restart(); // TODO: avoid this?
      /* prevRotationMarker = 0;
      rotationMarkers = 0;
      lastRotationDuration = 0;
      lastPower = 0;
      pedalStartTime = 0;
      millijoules = 0;
      pedalledTime = 0; */
      break;
#if defined(HEART_BEACON) || defined(HEART_CLIENT)      
    case RESCAN_HEART:
      NVS.setInt("heartAddress", 0);
      heartAddress = 0;
      bestHeartAddress = 0;
      bestHeartRSSI=-1000000;
      lastHeartRate = 0;
      if (heartScan != NULL && heartScan->isScanning()) 
        heartScan->stop();
#ifdef HEART_CLIENT
      startHeartScan();
#endif      
      break;
#endif
#if defined(HEART_CLIENT)      
    case RECONNECT_HEART:
      if (heartAddress) {
        heartConnectRetry = 0;
        needToConnectHeart = true;
        heartConnectAttemptTime = millis() + 1000 - heartConnectRetryTime;
      }
      break;
#endif
  }
}

bool menuActive = false;

void runMenu(bool dec, bool inc, bool resetMenu) {
  static unsigned option;
  static unsigned subOption;
  static unsigned top;
  static unsigned originalSubOption;
  
  bool redraw = false;
  
  if (resetMenu) {
    option = 0;
    top = 0;
    subOption = getSuboption(0);
    originalSubOption = subOption;
    redraw = true;
  }
  if (inc) {
    if (menuData[option].subOptions[0] == NULL) {
      setSuboption(option, 0);
      menuActive = false;
      needToClear = true;
    }
    else {
      redraw = true;
      subOption++;
      if (menuData[option].subOptions[subOption] == NULL)
        subOption = 0;
    }
  }
  if (dec) {
    redraw = true;
    if (originalSubOption != subOption) {
      setSuboption(option, subOption);
      originalSubOption = subOption;
    }
    else {
      option++;
      if (option >= NUM_OPTIONS)
        option = 0;
      subOption = getSuboption(option);
      originalSubOption = subOption;
    }
  }

  if (!redraw)
    return;

  if (option < top)
    top = option;
  else if (option >= top + ROWS)
    top = option - ROWS + 1;
    
  for (unsigned i = 0 ; i < ROWS ; i++) {
    setCursor(0,i);
    unsigned o = i + top;
    if (o < NUM_OPTIONS) {
      unsigned s;
      if (o == option) {
        s = subOption;
        if (subOption != originalSubOption)
          print("*");
        else
          print(">");
      }
      else {
        s = getSuboption(o);
        print(" ");
      }
      print(menuData[o].heading);
      if (menuData[o].subOptions[0] != NULL) {
        print(": ");
        print(menuData[o].subOptions[s]);      
      }
    }
    clearToEOL();
  }
}

// returns true if menu is supposed to be showing
bool menu(DebounceEvent* decP, DebounceEvent* incP) {
  static bool exitingMenu = false;
  static bool ignoreNextDecRelease = false;
  static uint32_t decPressedTime = (uint32_t)(-1);
  bool inc;
  bool dec;
  bool resetMenu = false;

  if (incButton.getLastState())
    decPressedTime = (uint32_t)(-1);

  if (*decP == DEBOUNCE_PRESSED && !menuActive) {
    decPressedTime = millis();
  }
  else {
    if (*decP == DEBOUNCE_RELEASED)
      decPressedTime = -1;
      
    if (decPressedTime != (uint32_t)(-1) && millis() >= decPressedTime + longPressTime ) {
      ignoreNextDecRelease = true;
      if (!menuActive) {
        menuActive = true;
        resetMenu = true;
        decPressedTime = (uint32_t)(-1);
      }
    }
  }

  inc = (*incP == DEBOUNCE_RELEASED);

  if (*decP == DEBOUNCE_RELEASED) {
    if (ignoreNextDecRelease) {
      ignoreNextDecRelease = false;
      *decP = DEBOUNCE_NONE;
    }
  }

  dec = (*decP == DEBOUNCE_RELEASED);

  if (menuActive) {
    *decP = DEBOUNCE_NONE;
    *incP = DEBOUNCE_NONE;
    
    runMenu(dec,inc,resetMenu);

    return true;
  }

  if (updateBluetooth) {
    ESP.restart(); // TODO: avoid this?
  }

  return false;
}

unsigned getHeartRate() {
#ifdef HEART  
  if (millis() < lastHeartRateTime + 6000)
    return lastHeartRate;
#endif
  return 0;  
}

void show(uint32_t crankRevolution,uint32_t power,uint32_t joules,uint32_t pedalledTime, uint32_t resistance, uint32_t rpm)
{
  if (needToClear) {
    clear();
  }
  
  char t[32];
  uint32_t orgTime = pedalledTime;
  pedalledTime /= 1000;
  unsigned sec = pedalledTime % 60;
  pedalledTime /= 60;
  unsigned min = pedalledTime % 60;
  pedalledTime /= 60;
  sprintf(t, "%u:%02u:%02u",(unsigned)pedalledTime,min,sec); 

  setCursor(0,0);
  printdigits(4,( joules * MJ_TO_KCALx1000 + 1000 * GROSS_EFFICIENCYx1000 / 2 ) / (1000 * GROSS_EFFICIENCYx1000) );
  print("cal ");
  printdigits(4, power);
  print("W ");
  printdigits(3, rpm);
  print("rpm ");

  if (showPeleton) {
    setCursor(0,2);
    print("R");
    printdigits(3,peletonResistances[resistance],true);
  }

#ifdef HEART
  if (heartReadEnabled) {
    setCursor(COLS-3-1,2);
    unsigned hr = getHeartRate();
    if (hr) {
      print("\2");
      printdigits(3,lastHeartRate);
    }
    else {
      clearToEOL();
    }
  }
#endif
  
  setCursor(0,3);
  print("L");
  printdigits(NUM_RESISTANCES<10 ? 1 : 2,resistance+1,true);
  print(bleConnected ? " \x01 " : "   ");
  print("#");
  printdigits(NUM_RESISTANCES<10 ? 6 : 5,crankRevolution,true);
  if (pedalledTime < 10)
    print(" ");
  print(t);
  orgTime /= 1000;
  if (orgTime == 0 || crankRevolution < 2) {
    return;
  }
  setCursor(0,1);
  print("   avg: ");
  printdigits(4, (joules+orgTime/2) / orgTime);
  print("W ");
  printdigits(3, crankRevolution * 60 / orgTime); 
  print("rpm");
}

void checkSave() {
  static uint32_t lastSavedTime = 0;
  if (resistanceValue == savedResistanceValue && brightnessValue == savedBrightnessValue)
    return;
  if ((millis() - lastSavedTime) < 4000)
    return; // reduce wear by not saving right away
  if (resistanceValue != savedResistanceValue) {
    NVS.setInt("res", resistanceValue);
    savedResistanceValue = resistanceValue;
  }
  if (brightnessValue != savedBrightnessValue) {
    NVS.setInt("bright", brightnessValue);
    savedBrightnessValue = brightnessValue;
  }
  lastSavedTime = millis();
}

void changeResistance(int32_t delta) {
  setResistance((resistanceValue + delta + NUM_RESISTANCES) % NUM_RESISTANCES);
}

void changeBrightness(int32_t delta) {
  int32_t nb = (int32_t)brightnessValue + delta;
  if (nb < 0)
    setBrightness(0);
  else if (nb > 255)
    setBrightness(255);
  else
    setBrightness(nb);
}

#ifdef SUPPORT_WIFI
static WiFiClient remoteClient;

void checkForConnections() {
  if (tcpServer.hasClient()) {
    if (remoteClient.connected()) {
      tcpServer.available().stop();
    }
    else {
      remoteClient = tcpServer.available();
    }
  }
}

#endif

void loop ()
{
  DebounceEvent incEvent = incButton.getEvent();
  DebounceEvent decEvent = decButton.getEvent();
  
  bool showedMenu = menu(&decEvent, &incEvent);
  
  switch(incEvent) {
    case DEBOUNCE_RELEASED:
      if (ignoreIncRelease)
        break;
      if (!decButton.getLastState()) {
        changeResistance(1);
      }
      else {
        changeBrightness(5);
        ignoreDecRelease = true;
      }
      break;
    case DEBOUNCE_PRESSED:
      ignoreIncRelease = false;
      break;
  }

  switch(decEvent) {
    case DEBOUNCE_RELEASED:
      if (ignoreDecRelease)
        break;
      if (!incButton.getLastState()) {
        changeResistance(-1);
      }
      else {
        changeBrightness(-5);
        ignoreIncRelease = true;
      }
      break;
    case DEBOUNCE_PRESSED:
      ignoreDecRelease = false;
      break;
  }

  checkSave();

#ifdef SUPPORT_WIFI
  if (wiFiMode)
    checkForConnections();
#endif  

  uint32_t t = millis();

#ifdef HEART_CLIENT
  if (needToConnectHeart && millis() - heartConnectAttemptTime >= heartConnectRetryTime) {
    Serial.println("connect request");
    heartConnect();
  }
#endif  

  if (! detectedRotation && 
#if defined( HEART_BEACON ) || defined( HEART_CLIENT )
  ! needToReportHeartRate &&
#endif  
  lastUpdateTime && t < lastUpdateTime + minimumUpdateTime)
    return;

  noInterrupts();
  bool updateCadence = detectedRotation;
  uint32_t rev = rotationMarkers ? rotationMarkers-1 : 0;
  uint32_t _lastPower = lastPower;
  uint32_t _millijoules = millijoules;
  uint32_t _prevRotationMarker = prevRotationMarker;
  if (_prevRotationMarker + idleTime <= t && rev && !detectedRotation) {
      pedalStartTime += t - lastUpdateTime;
  }
  detectedRotation = false;
  uint32_t _pedalStartTime = pedalStartTime;
  uint32_t _lastRotationDuration = lastRotationDuration;
  interrupts();

  uint32_t rpm;
  uint32_t rpm_x2;
  uint32_t _power = _lastPower;
  if (!rev || _lastRotationDuration == 0) {
    rpm = 0;
    rpm_x2 = 0;
  }
  else {
    uint32_t dt;
    
    if (_lastRotationDuration < t - prevRotationMarker) {
      dt = t - prevRotationMarker;
      _power = calculatePower(dt);
    }
    else {
      dt = _lastRotationDuration;
    }
    
    rpm = (60000 + dt/2) / dt;
    rpm_x2 = (120000 + dt/2) / dt;
  }

  noInterrupts();
  if (!showedMenu) 
    show(rev, _power, _millijoules/1000, _pedalStartTime ? t - _pedalStartTime : 0, resistanceValue, rpm);
  interrupts();

  lastUpdateTime = t;

#ifdef SUPPORT_WIFI
  if (wiFiMode && remoteClient.connected()) {
    static uint32_t lastReportedRotationMarker = 0;
    remoteClient.printf("time %lu\n", t);
    remoteClient.printf("power %u\n", _power);
    remoteClient.printf("cadence %u\n", rpm);
    remoteClient.printf("level %u\n", resistanceValue);
    if (lastReportedRotationMarker != _prevRotationMarker) {
      remoteClient.printf("rotation %u %u\n", rev, _prevRotationMarker);
      lastReportedRotationMarker = _prevRotationMarker;
    }
#if defined( HEART_BEACON ) || defined( HEART_CLIENT ) // TODO: add HEART_PIN support
    static unsigned lastReportedHeartRate = 0;
    unsigned hr = getHeartRate();
    if (needToReportHeartRate || lastReportedHeartRate != hr) {
      needToReportHeartRate = false;      
      lastReportedHeartRate = hr;
      remoteClient.printf("heart %u\n", hr);
    }
#endif
    return;
    
  }
#endif  

  if (!bleConnected || updateBluetooth)
    return;

  uint32_t lastCrankRevolution = getTime1024ths(_prevRotationMarker);

  powerMeasurement.instantaneousPower = _lastPower;
  powerMeasurement.crankRevolutions = rev;
  powerMeasurement.lastCrankEvent = lastCrankRevolution;
#ifdef WHEEL  
  uint32_t wheelRevolutions = rev * gearRatio1 / gearRatio2;
//  powerMeasurement.wheelRevolutions = wheelRevolutions;
//  powerMeasurement.lastWheelEvent = lastCrankRevolution; // TODO: make better
#endif      

#ifdef POWER
  if (powerServiceEnabled) {
    powerMeasurementCharacteristics.setValue((uint8_t*)&powerMeasurement, sizeof(powerMeasurement));
    powerMeasurementCharacteristics.notify();
  }
#endif  

  cscMeasurement.crankRevolutions = rev;
  cscMeasurement.lastCrankEvent = lastCrankRevolution;
#ifdef WHEEL  
  cscMeasurement.wheelRevolutions = wheelRevolutions;
  cscMeasurement.lastWheelEvent = lastCrankRevolution; // TODO: make better
#endif  

#ifdef CADENCE
  if (cadenceServiceEnabled) {
    cscMeasurementCharacteristics.setValue((uint8_t*)&cscMeasurement, sizeof(cscMeasurement));
    cscMeasurementCharacteristics.notify();
  }
#endif  

#ifdef HEART_PIN
  static uint32_t lastHeartRateUpdate = 0;

  if (millis() >= lastHeartRateUpdate + 1000 && lastHeartBeatDuration > 0 && millis() <= prevHeartBeat + 4000) {
    uint16_t heartRate = (60000 + lastHeartBeatDuration/2) / lastHeartBeatDuration;
    lastHeartRate = heartRate;
    lastHeartRateTime = prevHeartBeat;

    if (heartServiceEnabled) {    
      if (heartRate <= 255) {
        heartMeasurement8.heartRate = heartRate;
        heartMeasurementCharacteristics.setValue((uint8_t*)&heartMeasurement8, sizeof(HeartMeasurement8_t));
      }
      else {
        heartMeasurement8.heartRate = heartRate;
        heartMeasurementCharacteristics.setValue((uint8_t*)&heartMeasurement16, sizeof(HeartMeasurement16_t));
      }
      heartMeasurementCharacteristics.notify();
    }
    lastHeartRateUpdate = millis();
  }
#endif  

#if defined( HEART_BEACON ) || defined( HEART_CLIENT )
  if (needToReportHeartRate) {
    needToReportHeartRate = false;
    
    if (heartServiceEnabled && lastHeartRate > 0) {
      if (lastHeartRate <= 255) {
        heartMeasurement8.heartRate = lastHeartRate;
        heartMeasurementCharacteristics.setValue((uint8_t*)&heartMeasurement8, sizeof(HeartMeasurement8_t));
      }
      else {
        heartMeasurement8.heartRate = lastHeartRate;
        heartMeasurementCharacteristics.setValue((uint8_t*)&heartMeasurement16, sizeof(HeartMeasurement16_t));
      }
      heartMeasurementCharacteristics.notify();
    }    
  }
#endif

#ifdef FITNESS
  if (fitnessServiceEnabled) {
    bikeData.cadence_x2 = rpm_x2;
    bikeData.power = _power;
    bikeData.resistance = 1 + resistanceValue;
    unsigned hr = 0;
    bikeData.flags &= ~BIKE_DATA_FLAG_HEART;
#ifdef HEART
    hr = getHeartRate();
    if (hr) {
      bikeData.heart = hr;
      bikeData.flags |= BIKE_DATA_FLAG_HEART;
    }
#endif    
    bikeDataCharacteristics.setValue((uint8_t*)&bikeData,
      hr ? sizeof(BikeData_t) : sizeof(BikeData_t)-1);
    bikeDataCharacteristics.notify();
  }
#endif


}
