arpruss/BLEBike/(commit log)

2023-01-03 use better bike resistance data
2023-01-11 use interrupts
2023-01-16 power now does cadence
2023-01-16 fix disconnect / reconnect issue
    [BLEBike.ino]
2023-01-16 support wheel data
2023-01-17 power feature is 4 bytes, not 1
2023-02-02 distance filter
2023-02-08 FTMS works, though HR doesn't show up in RGT
    [BLEBike.ino]
2023-02-15 initial support for other beaconish devices
2023-04-15 reboot instead of clear
    [BLEBike.ino]
